KevinLeonardoHUB/armiac-pap/Videos - EN.md

All videos on the youtube channel:

**https://www.youtube.com/@tavaresndrobotics**

* First test with servo - **https://youtube.com/shorts/2wemvdqr7-U?si=w8FRQI1J4Jo3bf\_\_**
* 3d impression phase - **https://youtube.com/shorts/XccsXvw3TjE?si=VTkn\_LDn9RA-lZOL**
* Fingers demonstration - **https://youtube.com/shorts/j9Mxo\_9-ovw?si=ev9iDQ6k6s86yzmm**
* Arm's first demonstration - **https://youtube.com/shorts/-pQoMxjrOXw?si=h5VoXeKYmMXfyiB4c**
* February version demonstration - **https://www.youtube.com/watch?v=dLHhLJuH\_1o\&t=3s**
* Unfinished app demonstration - **https://www.youtube.com/shorts/C5wIR47ePRw**
* Battery error explanation - **https://youtu.be/RV1m9Q8S5C0?si=DbCZy6Hms4ChPk9Q**
* Final demonstration - **https://www.youtube.com/watch?v=DZ1Mz6-E2Yc\&t=5s**

**ALL THE ABOVE VIDEOS ARE IN PORTUGUESE(MY NATIVE LANGUAGE), BUT EVERY VIDEO HAS AI GENERATED SUBTITLES PROVIDED BY YOUTUBE!!!**
