KevinLeonardoHUB/armiac-pap/Videos - PT.md

Todos os videos estão no canal:

**https://www.youtube.com/@tavaresndrobotics**

* Primeiro teste com servo - **https://youtube.com/shorts/2wemvdqr7-U?si=w8FRQI1J4Jo3bf\_\_**
* Fase de impressão 3D - **https://youtube.com/shorts/XccsXvw3TjE?si=VTkn\_LDn9RA-lZOL**
* Demonstração dos dedos - **https://youtube.com/shorts/j9Mxo\_9-ovw?si=ev9iDQ6k6s86yzmm**
* Primeira demonstração do braço - **https://youtube.com/shorts/-pQoMxjrOXw?si=h5VoXeKYmMXfyiB4c**
* Demonstração versão de fevereiro - **https://www.youtube.com/watch?v=dLHhLJuH\_1o\&t=3s**
* Demonstração APP inacabada - **https://www.youtube.com/shorts/C5wIR47ePRw**
* Explicação erro de bateria - **https://youtu.be/RV1m9Q8S5C0?si=DbCZy6Hms4ChPk9Q**
* Demonstração final - **https://www.youtube.com/watch?v=DZ1Mz6-E2Yc\&t=5s**
