KevinLeonardoHUB/armiac-pap/app_flutter/assets/tutorial/armiac_wifi.png

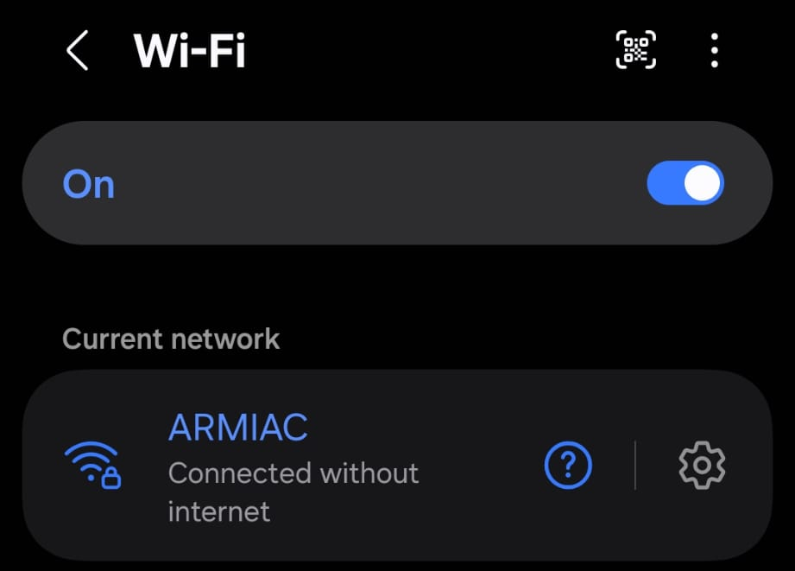
app_flutter/assets/tutorial/armiac_wifi.png
